TobyBorland/temperature_gauge/(commit log)

2026-01-04 Enhance README with project details and images
    Expanded the README to provide detailed information about the oil temperature gauge project, including its purpose, components, and circuit details.
2026-01-04 Update thermistor section in README
    Updated the thermistor section with new image reference and details about later kz650 models.
2026-01-04 Update thermistor information and image
    Updated the thermistor section with new image and details.
2026-01-04 Add thermistor display functionality
    Implement oil temperature gauge display using thermistor.
2026-01-04 Update thermistor measurement section in README
    Clarified thermistor measurement details and added reference to polynomial fitting and spreadsheet calculations.
